nerdha/Nixie_Monroe/README.md

Nixie_Monroe
============

Boards and code for the nixie clock I made from the tubes of an old Monroe 610 calculator and a log reclaimed from a tree destroyed by Hurricane Sandy.

http://www.flickr.com/photos/hmason/8914375124/
