nerdha/Nixie_Monroe/boards/monroe-half-hi.brd

## EAGLE design boards/monroe-half-hi.brd (2013-01-19)

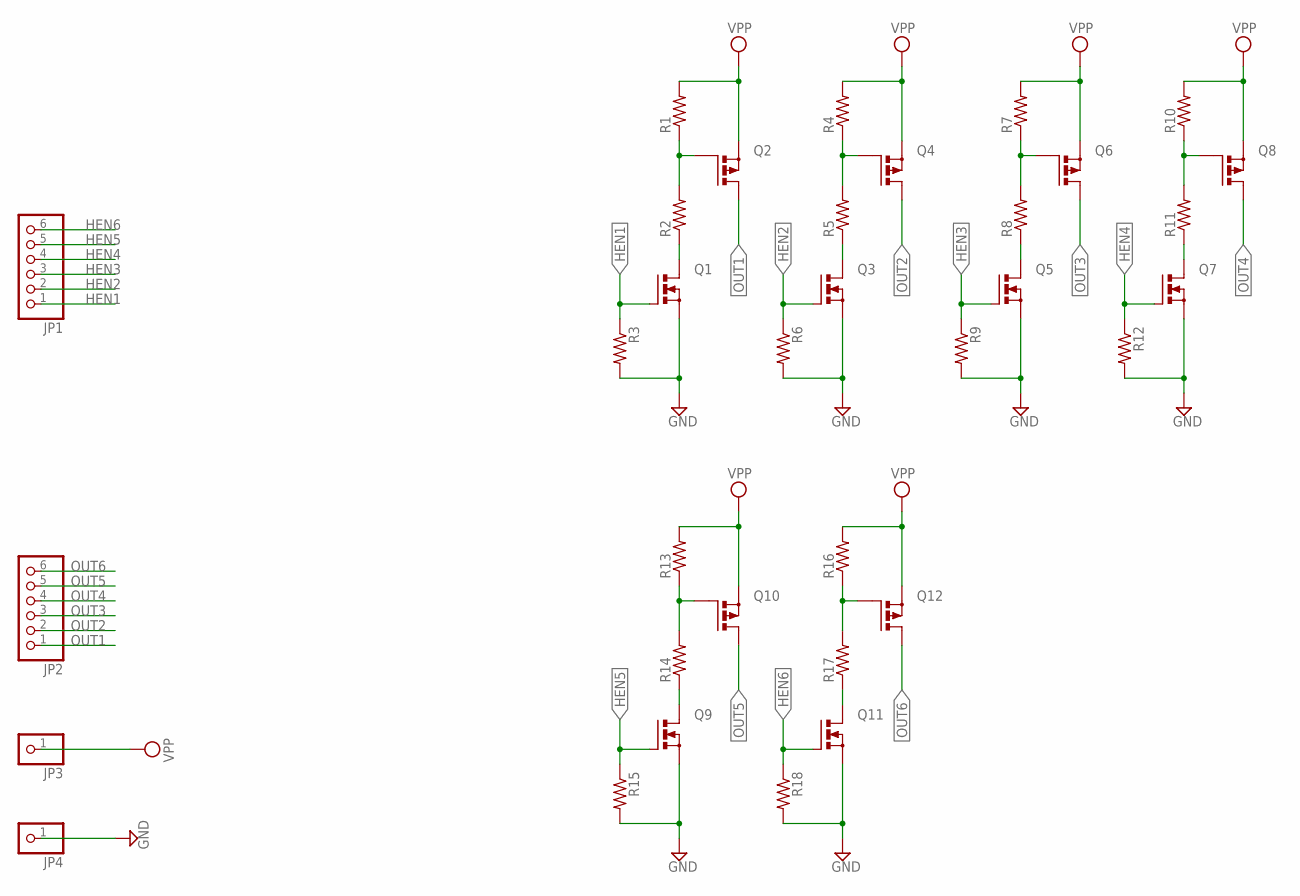
[picture p1: schematic monroe-half-hi.sch]

Parts:
JP1, JP2: PINHD-1X6; 1X06
JP3, JP4: PINHD-1X1; 1X01
Q1, Q3, Q5, Q7, Q9, Q11: PMOSFET_NTO220BV; TO220BV
Q2, Q4, Q6, Q8, Q10, Q12: PMOSFET_PTO220BV; TO220BV
R1, R3, R4, R6, R7, R9, R10, R12, R13, R15, R16, R18: R-US_0207/5V; 0207/5V
R2, R5, R8, R11, R14, R17: R-US_0207/10; 0207/10

Connections:
GND: JP4.1, Q1.S, Q3.S, Q5.S, Q7.S, Q9.S, Q11.S, R3.2, R6.2, R9.2, R12.2, R15.2, R18.2
HEN1: JP1.1, Q1.G, R3.1
HEN2: JP1.2, Q3.G, R6.1
HEN3: JP1.3, Q5.G, R9.1
HEN4: JP1.4, Q7.G, R12.1
HEN5: JP1.5, Q9.G, R15.1
HEN6: JP1.6, Q11.G, R18.1
unnamed: Q2.G, R1.1, R2.2
unnamed: Q1.D, R2.1
unnamed: Q4.G, R4.1, R5.2
unnamed: Q3.D, R5.1
unnamed: Q6.G, R7.1, R8.2
unnamed: Q5.D, R8.1
unnamed: Q8.G, R10.1, R11.2
unnamed: Q7.D, R11.1
unnamed: Q10.G, R13.1, R14.2
unnamed: Q9.D, R14.1
unnamed: Q12.G, R16.1, R17.2
unnamed: Q11.D, R17.1
OUT1: JP2.1, Q2.D
OUT2: JP2.2, Q4.D
OUT3: JP2.3, Q6.D
OUT4: JP2.4, Q8.D
OUT5: JP2.5, Q10.D
OUT6: JP2.6, Q12.D
VPP: JP3.1, Q2.S, Q4.S, Q6.S, Q8.S, Q10.S, Q12.S, R1.2, R4.2, R7.2, R10.2, R13.2, R16.2

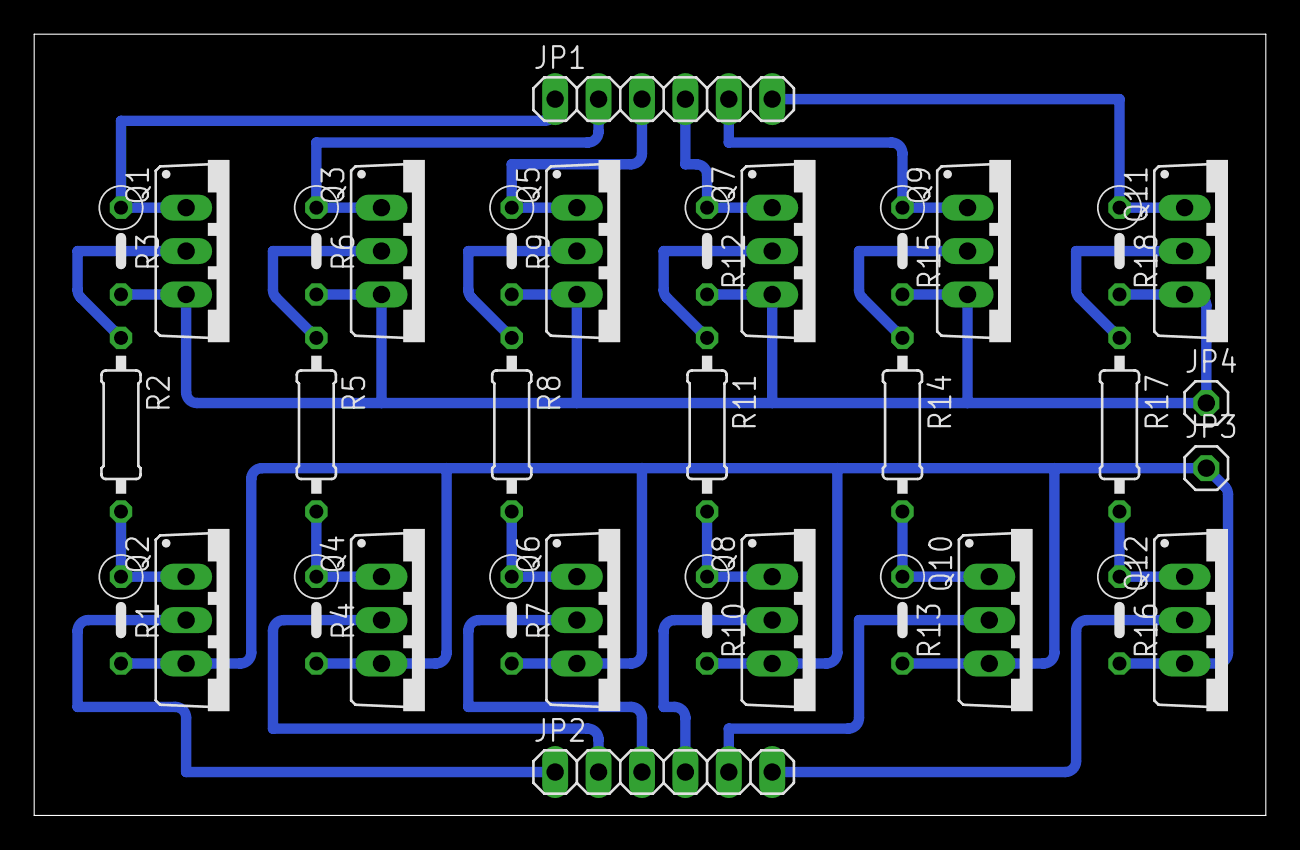
[picture p2: board monroe-half-hi.brd from above]

Board: 2 copper layers, 72.1 x 45.7 mm, 34 parts (0 on the bottom side), 26 nets.
