nerdha/Nixie_Monroe/boards/monroe-lo.brd

## EAGLE design boards/monroe-lo.brd (2013-01-19)

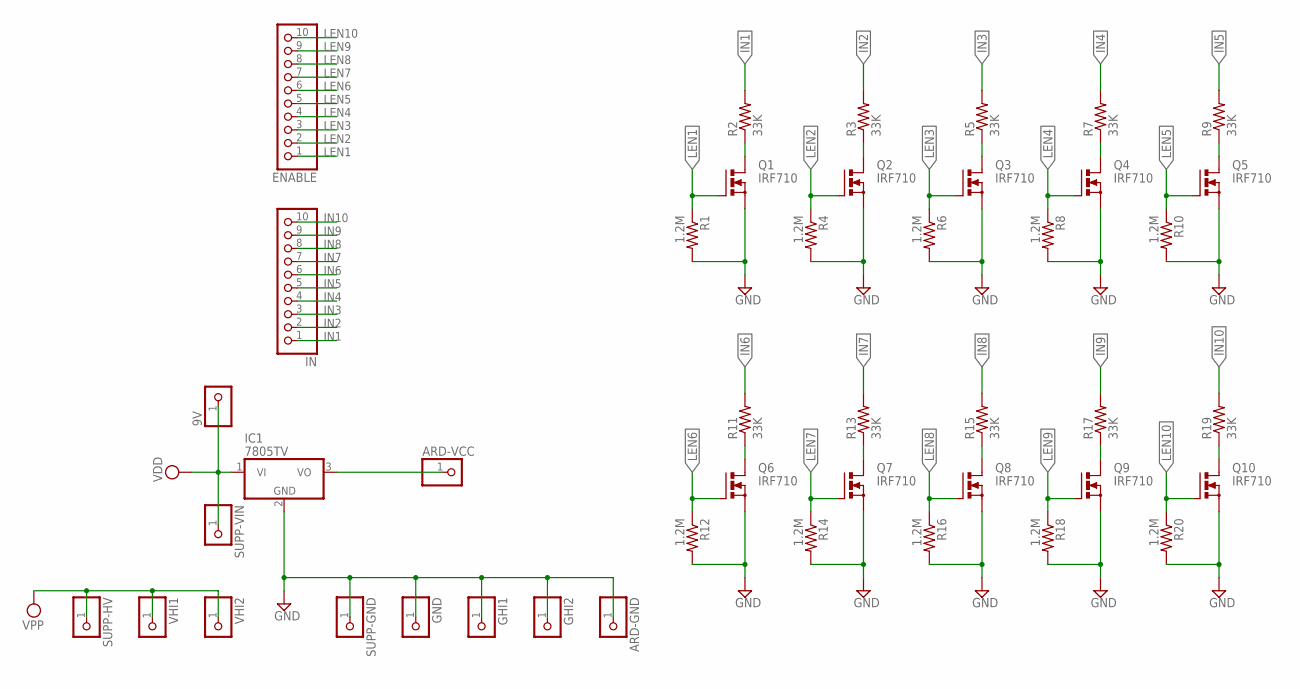
[picture p3: schematic monroe-lo.sch]

Parts:
9V: PINHD-1X1; 1X01
ARD-GND: PINHD-1X1; 1X01
ARD-VCC: PINHD-1X1; 1X01
ENABLE: PINHD-1X10; 1X10
GHI1, GHI2: PINHD-1X1; 1X01
GND: PINHD-1X1; 1X01
IC1: 7805TV; TO220V
IN: PINHD-1X10; 1X10
Q1, Q2, Q3, Q4, Q5, Q6, Q7, Q8, Q9, Q10: IRF710; TO220BV
R1, R4, R6, R8, R10, R12, R14, R16, R18, R20: 1.2M; 0207/2V
R2, R3, R5, R7, R9, R11, R13, R15, R17, R19: 33K; 0207/7
SUPP-GND: PINHD-1X1; 1X01
SUPP-HV: PINHD-1X1; 1X01
SUPP-VIN: PINHD-1X1; 1X01
VHI1, VHI2: PINHD-1X1; 1X01

Connections:
GND: ARD-GND.1, GHI1.1, GHI2.1, GND.1, IC1.2 (GND), Q1.S, Q2.S, Q3.S, Q4.S, Q5.S, Q6.S, Q7.S, Q8.S, Q9.S, Q10.S, R1.2, R4.2, R6.2, R8.2, R10.2, R12.2, R14.2, R16.2, R18.2, R20.2, SUPP-GND.1
IN1: IN.1, R2.2
IN2: IN.2, R3.2
IN3: IN.3, R5.2
IN4: IN.4, R7.2
IN5: IN.5, R9.2
IN6: IN.6, R11.2
IN7: IN.7, R13.2
IN8: IN.8, R15.2
IN9: IN.9, R17.2
IN10: IN.10, R19.2
LEN1: ENABLE.1, Q1.G, R1.1
LEN2: ENABLE.2, Q2.G, R4.1
LEN3: ENABLE.3, Q3.G, R6.1
LEN4: ENABLE.4, Q4.G, R8.1
LEN5: ENABLE.5, Q5.G, R10.1
LEN6: ENABLE.6, Q6.G, R12.1
LEN7: ENABLE.7, Q7.G, R14.1
LEN8: ENABLE.8, Q8.G, R16.1
LEN9: ENABLE.9, Q9.G, R18.1
LEN10: ENABLE.10, Q10.G, R20.1
unnamed: Q2.D, R3.1
unnamed: Q1.D, R2.1
unnamed: Q3.D, R5.1
unnamed: Q4.D, R7.1
unnamed: Q5.D, R9.1
unnamed: Q6.D, R11.1
unnamed: Q7.D, R13.1
unnamed: Q8.D, R15.1
unnamed: Q9.D, R17.1
unnamed: Q10.D, R19.1
unnamed: ARD-VCC.1, IC1.3 (VO)
VDD: 9V.1, IC1.1 (VI), SUPP-VIN.1
VPP: SUPP-HV.1, VHI1.1, VHI2.1

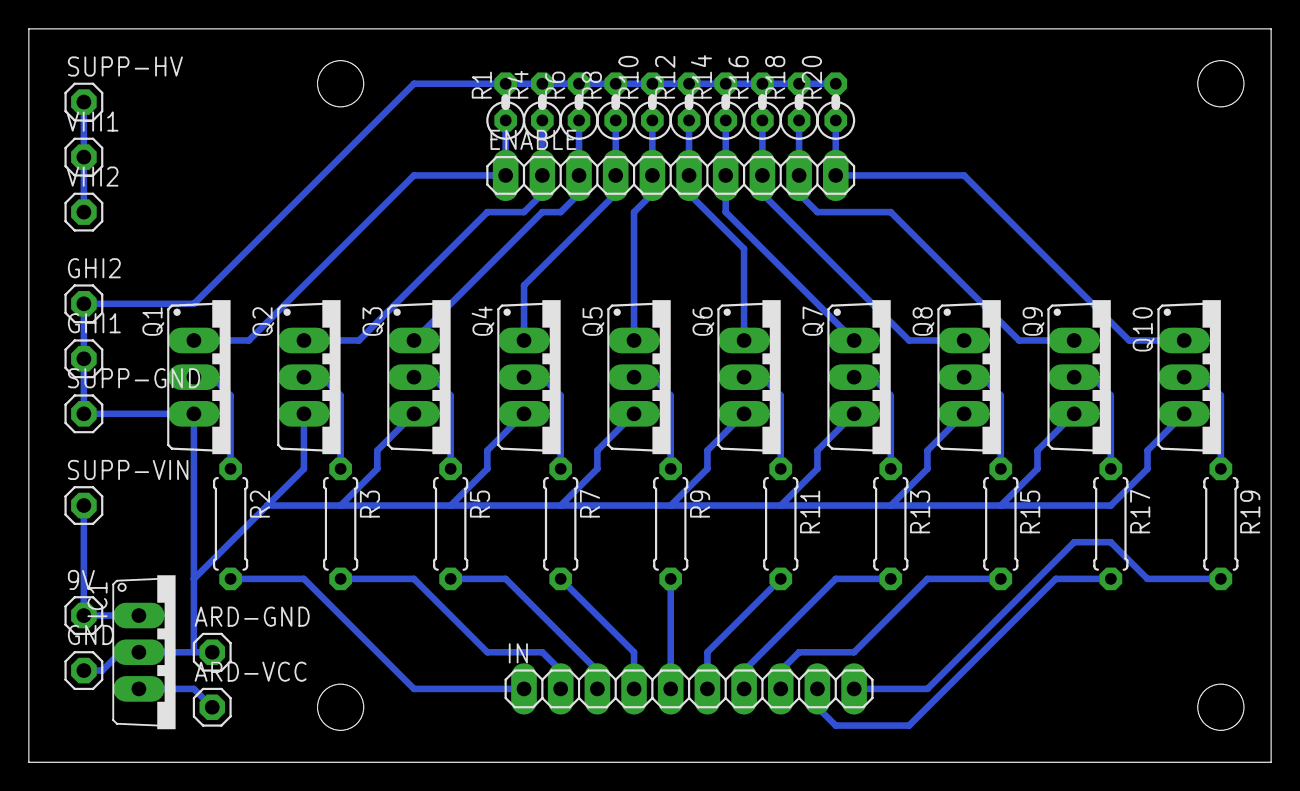
[picture p4: board monroe-lo.brd from above]

Board: 2 copper layers, 86.0 x 50.8 mm, 44 parts (0 on the bottom side), 34 nets.
