nerdha/Nixie_Monroe/(commit log)

2013-01-19 initial comit
    [monroe-half-hi.brd, monroe-half-hi.sch, monroe-hi.sch, monroe-lo.brd, monroe-lo.sch]
2013-01-20 commented and cleaned arduino sketch
